danzelphotos-tech/Guardian/figures/bicep_curl_flex_vs_imu.png

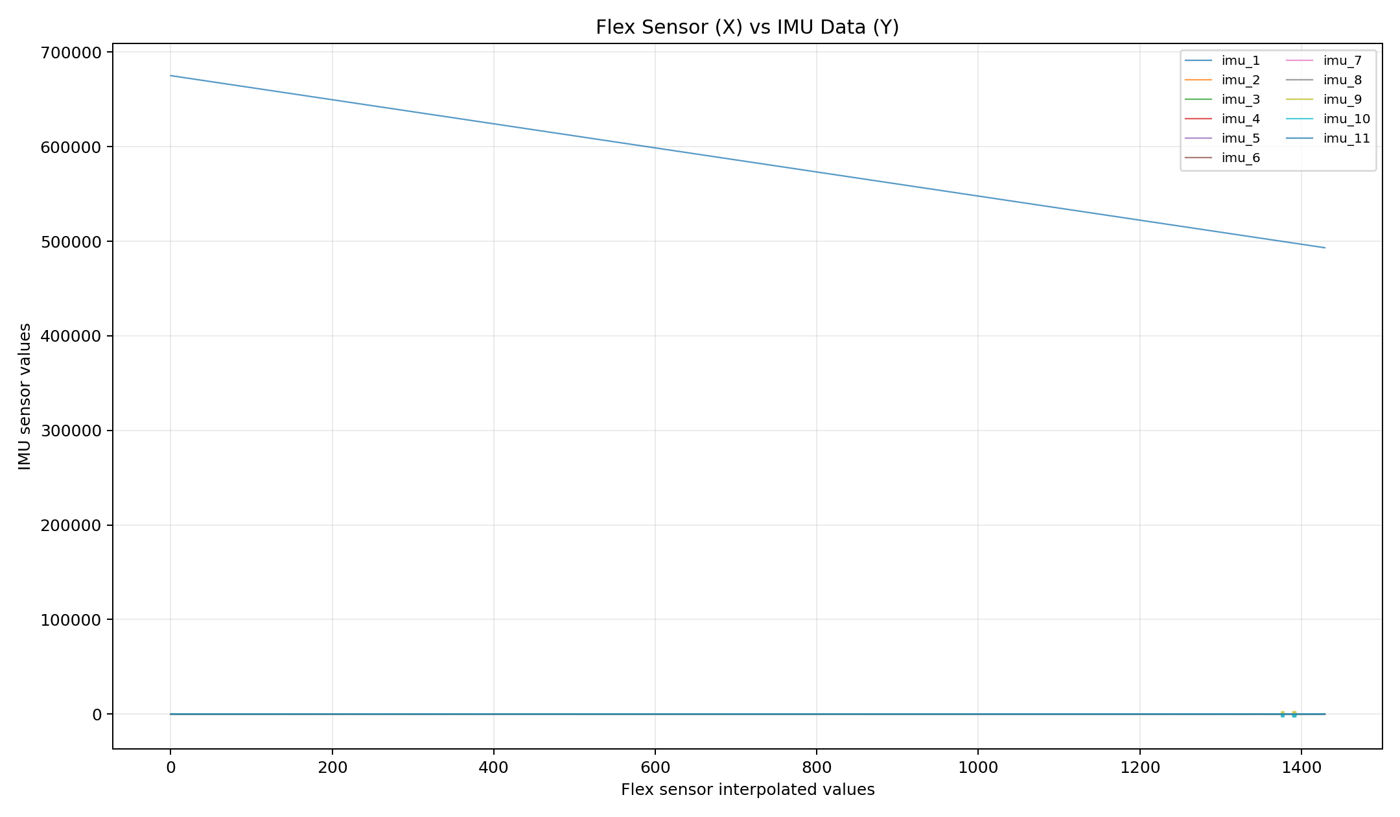
figures/bicep_curl_flex_vs_imu.png
