danzelphotos-tech/Guardian/figures/curl_analysis.png

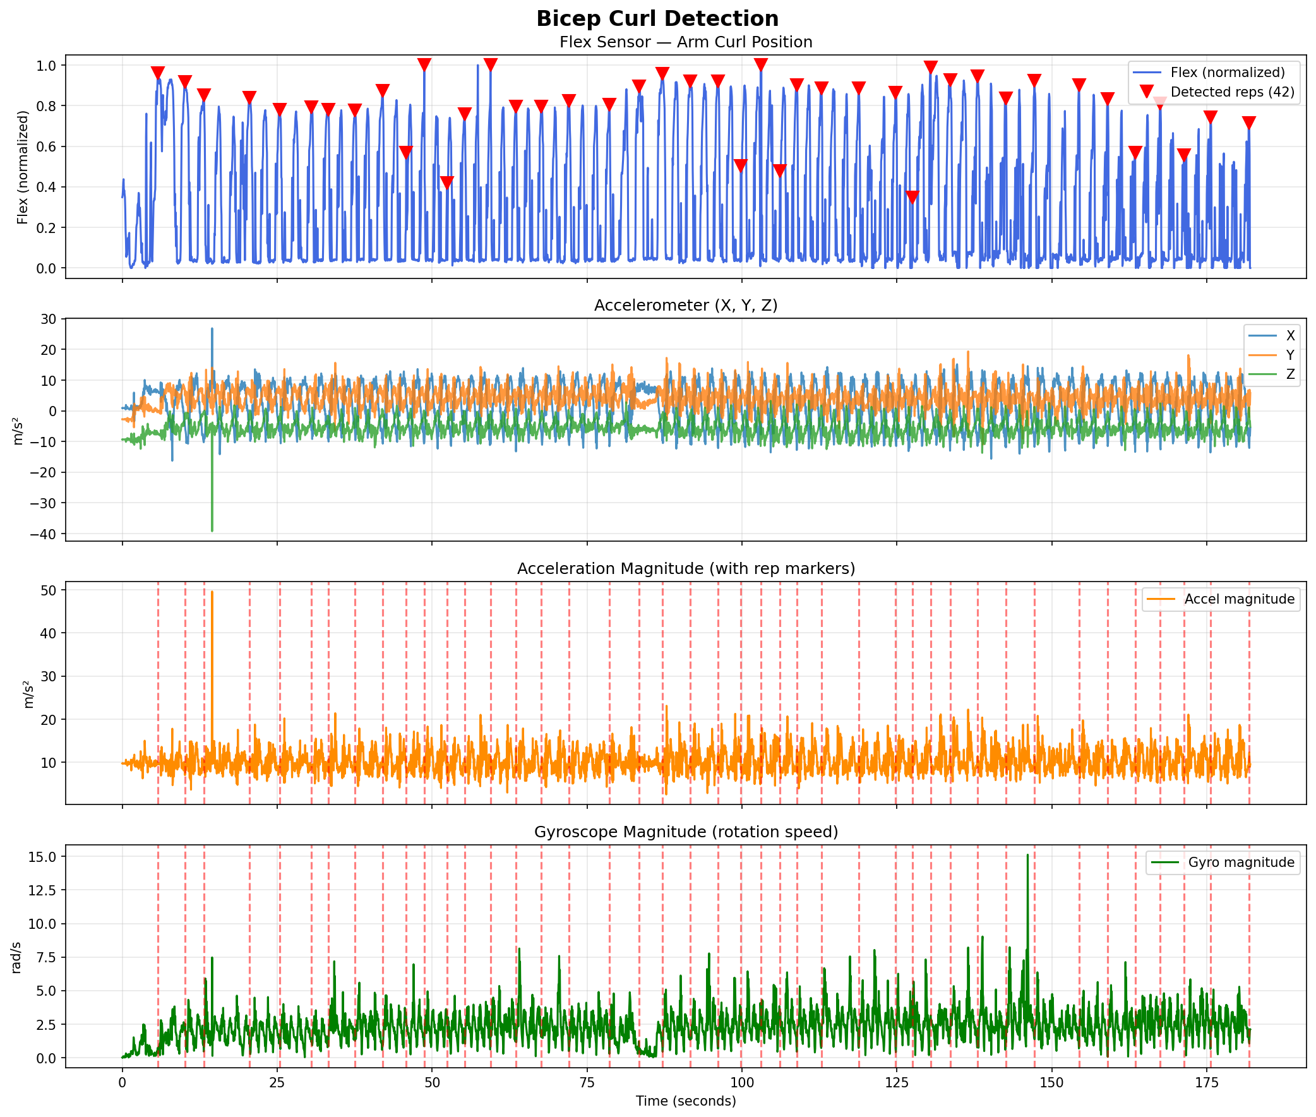
figures/curl_analysis.png
