danzelphotos-tech/Guardian/figures/curl_filtered.png

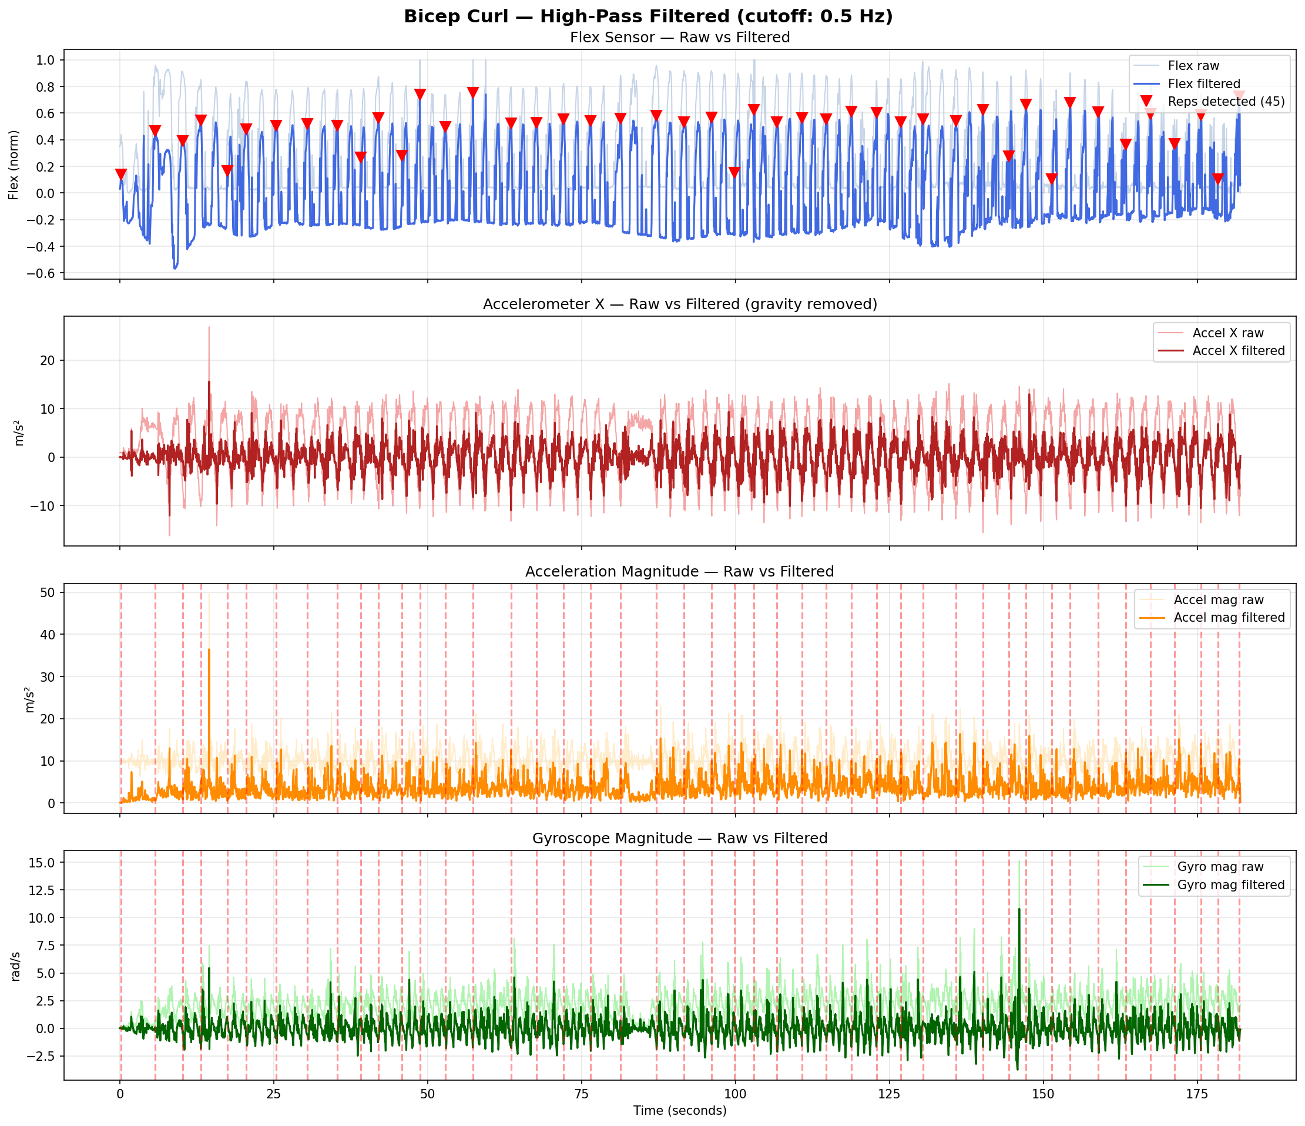
figures/curl_filtered.png
