danzelphotos-tech/Guardian/figures/fig1_flex.png

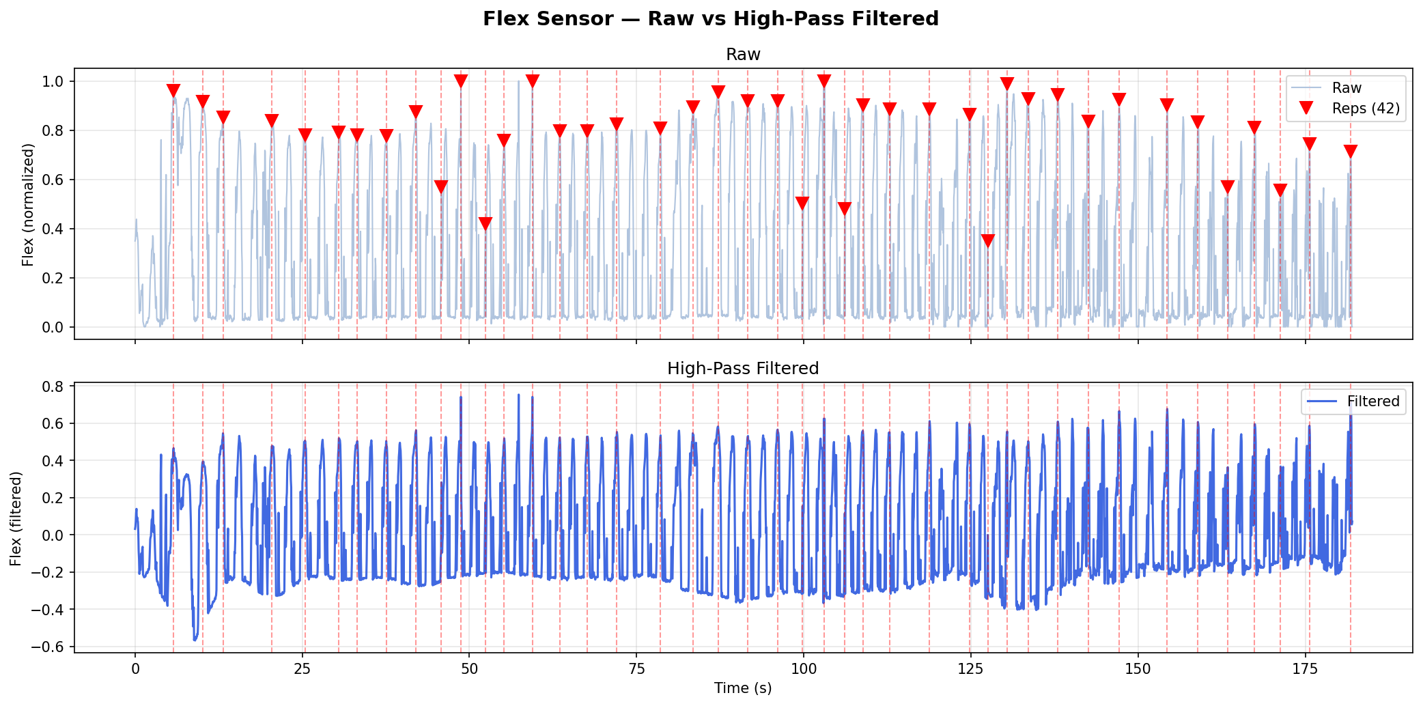
figures/fig1_flex.png
