danzelphotos-tech/Guardian/figures/fig2_accel_x.png

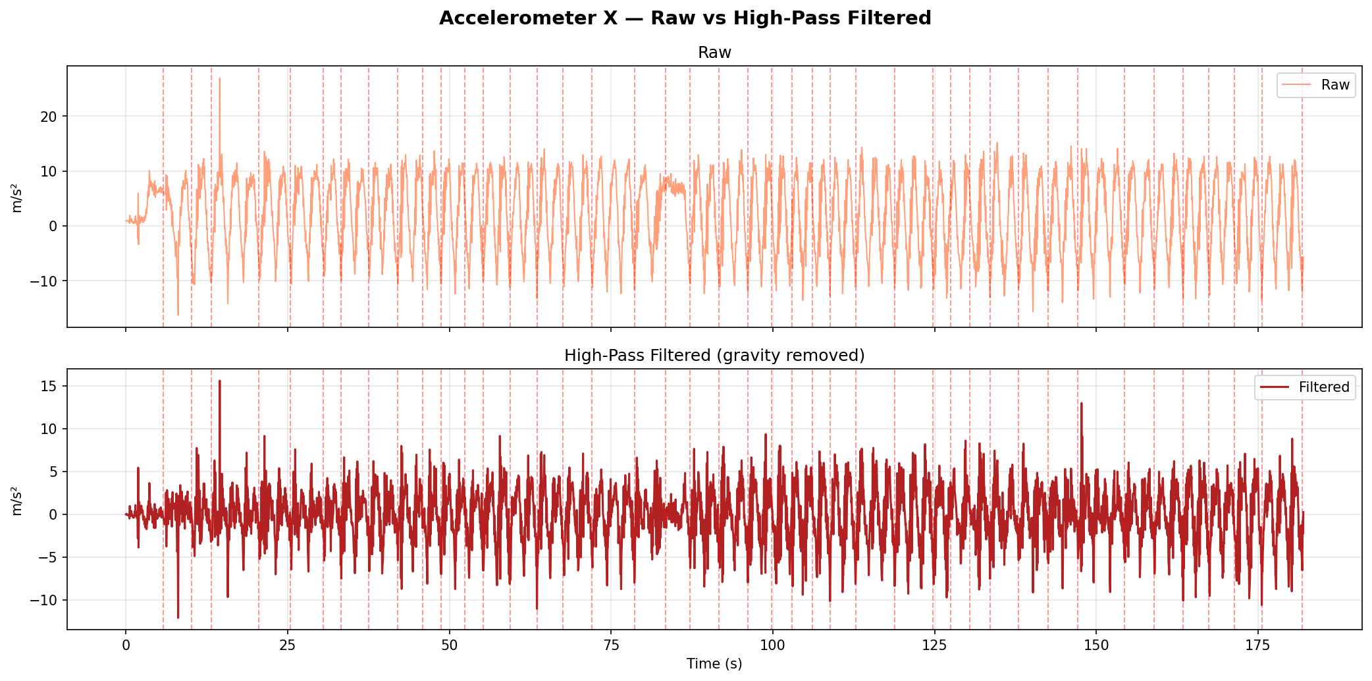
figures/fig2_accel_x.png
