danzelphotos-tech/Guardian/figures/fig3_accel_y.png

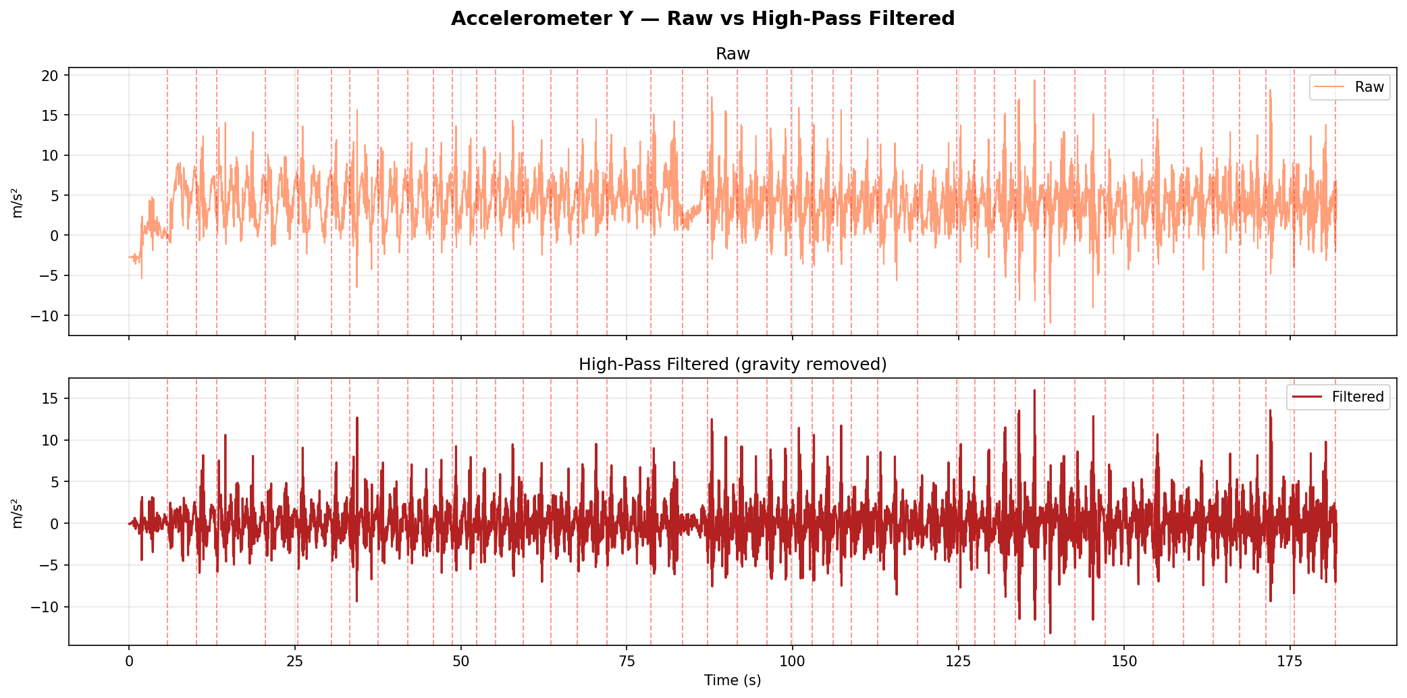
figures/fig3_accel_y.png
