danzelphotos-tech/Guardian/figures/fig4_accel_z.png

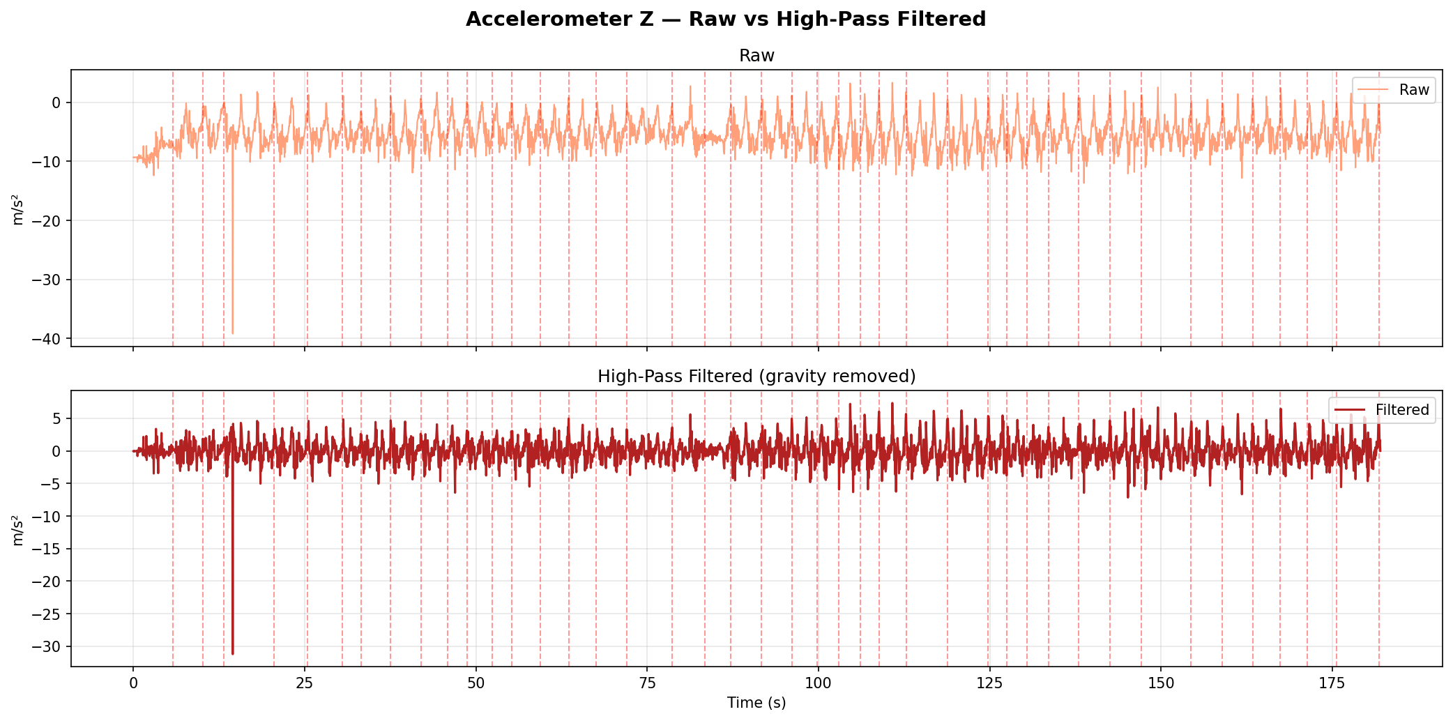
figures/fig4_accel_z.png
