danzelphotos-tech/Guardian/figures/fig5_accel_mag.png

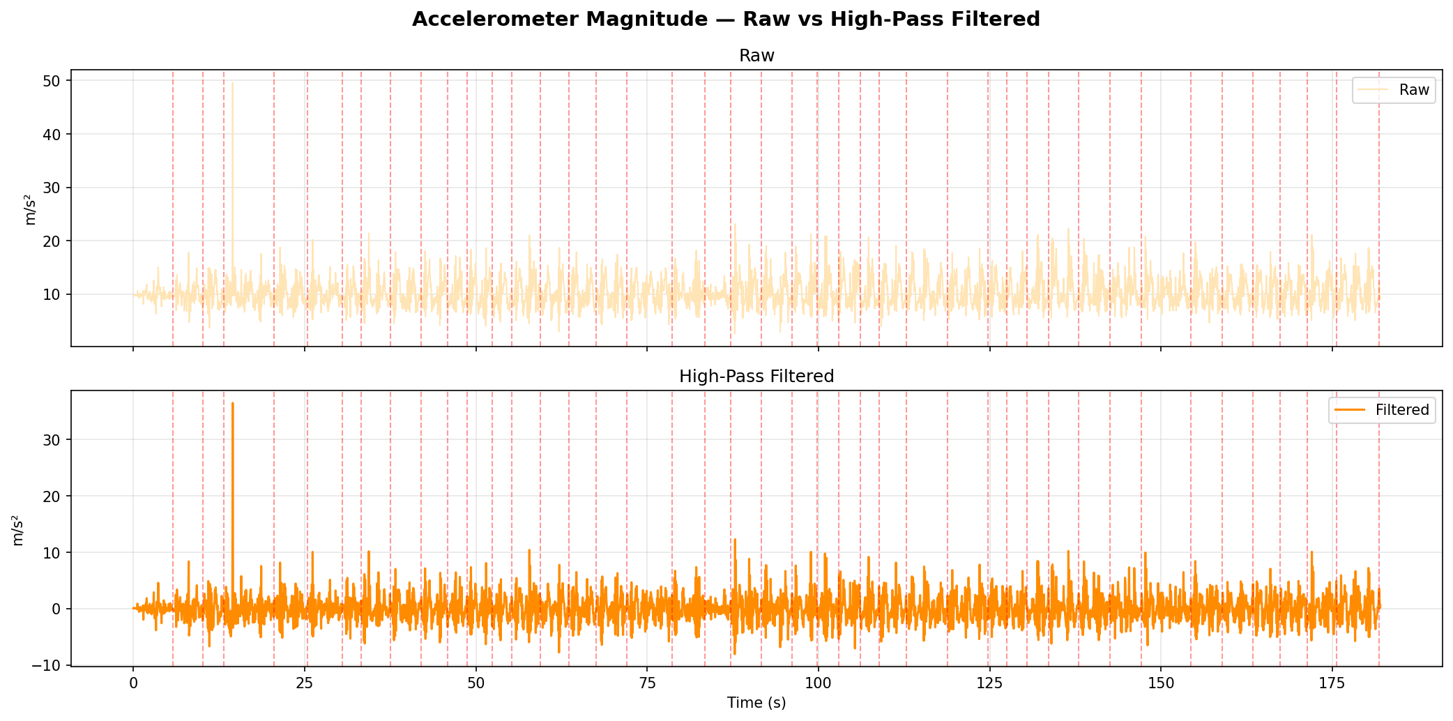
figures/fig5_accel_mag.png
