danzelphotos-tech/Guardian/figures/fig6_gyro_x.png

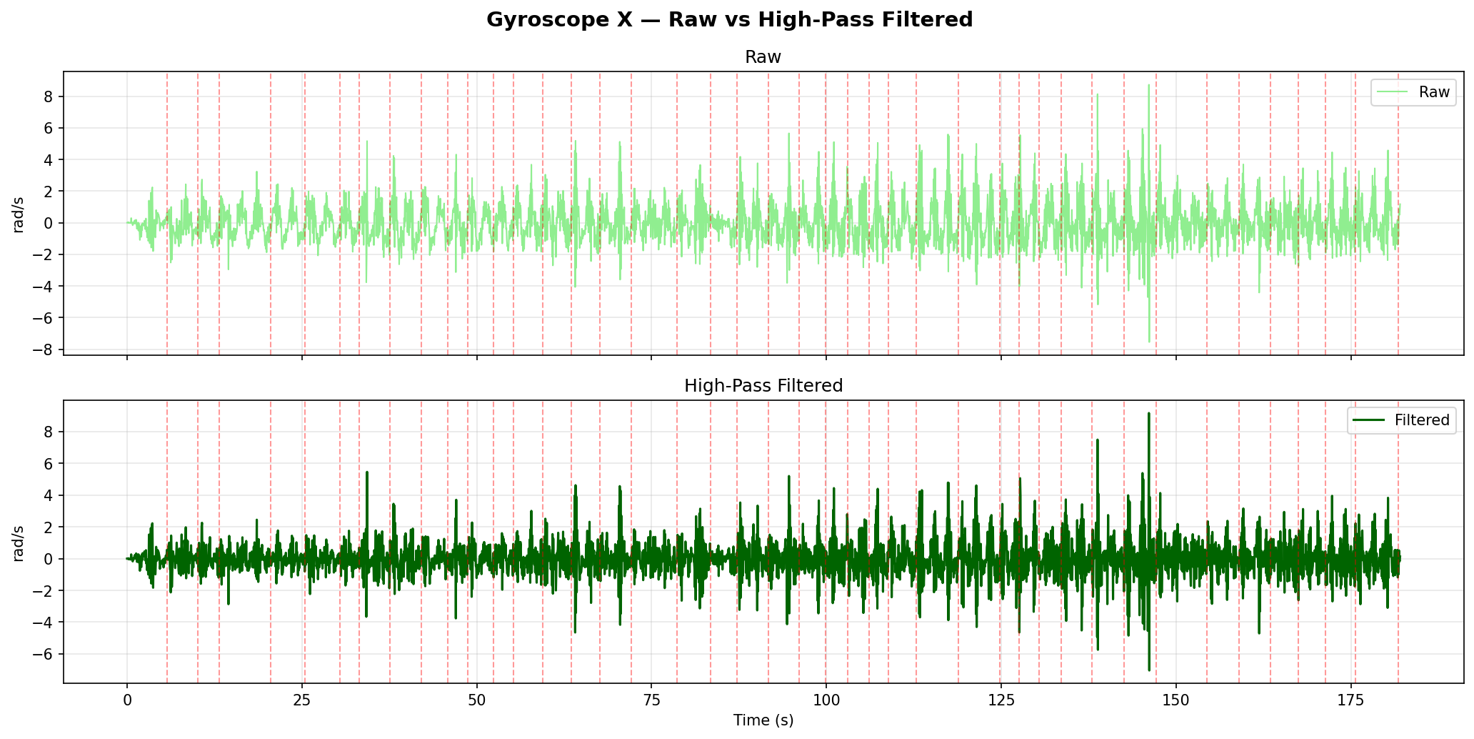
figures/fig6_gyro_x.png
