danzelphotos-tech/Guardian/figures/fig7_gyro_y.png

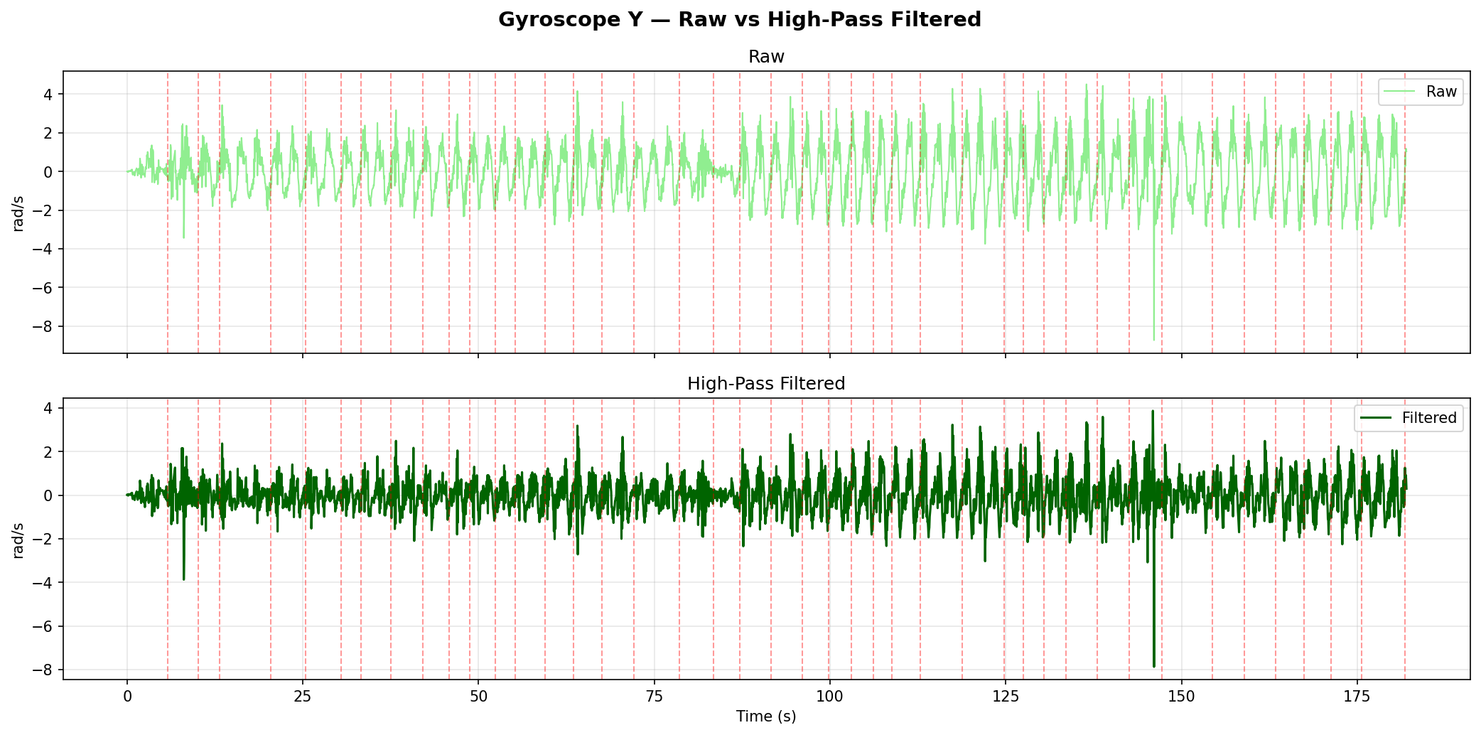
figures/fig7_gyro_y.png
