danzelphotos-tech/Guardian/figures/fig8_gyro_z.png

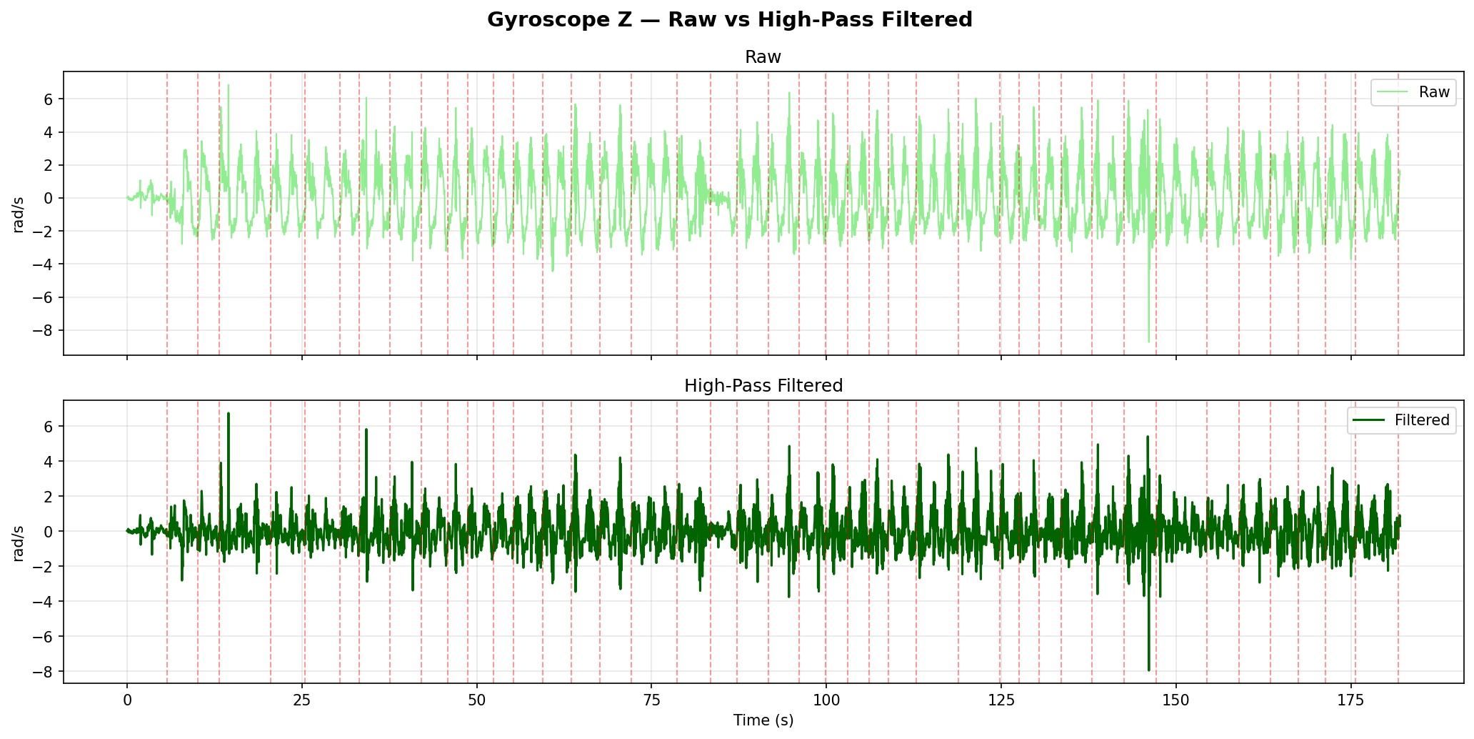
figures/fig8_gyro_z.png
