danzelphotos-tech/Guardian/figures/fig9_gyro_mag.png

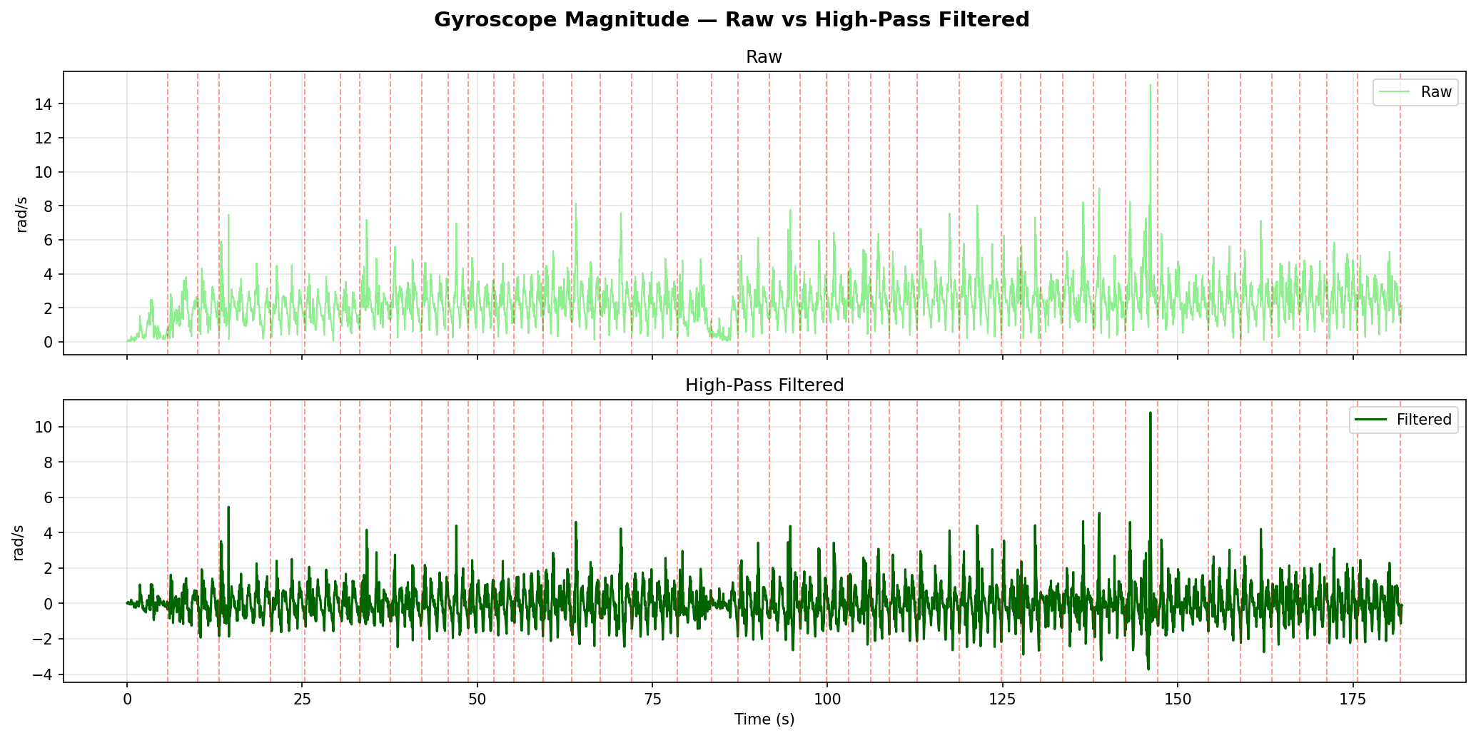
figures/fig9_gyro_mag.png
