danzelphotos-tech/Guardian/capture_veronika/Guardian — Veronika's LED Feedback Sandbox.pdf

Guardian — LED Feedback Sandbox

Load your CSVs, simulate reps from real data, and watch the LED respond to good vs bad form.

capture_veronika / simulation-dashboard-veronika.html

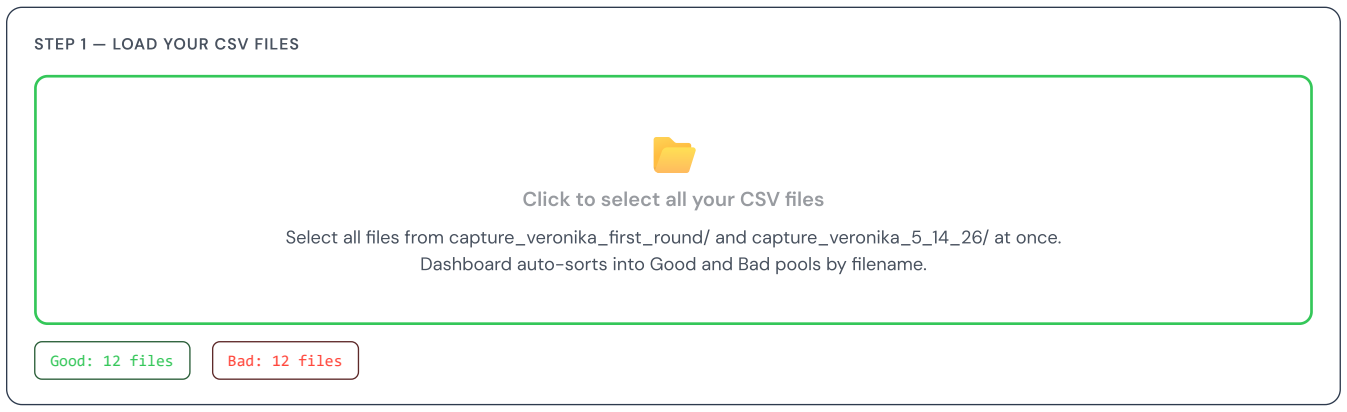
[picture p13: figure]
STEP 1 — LOAD YOUR CSV FILES; Click to select all your CSV files; Good: 12 files; Bad: 12 files

Select all files from capture_veronika_first_round/ and capture_veronika_5_14_26/ at once.

Dashboard auto-sorts into Good and Bad pools by filename.

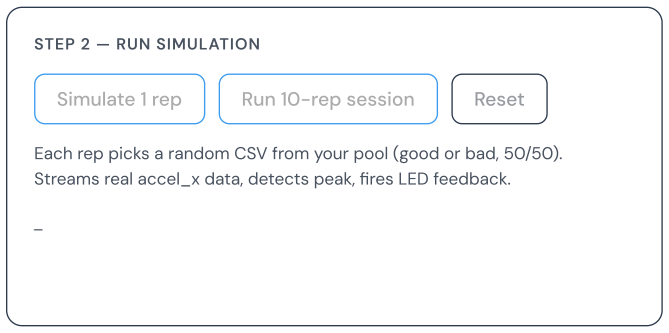
[picture p14: figure]
STEP 2 — RUN SIMULATION; Simulate 1 rep; Run 10-rep session; Reset
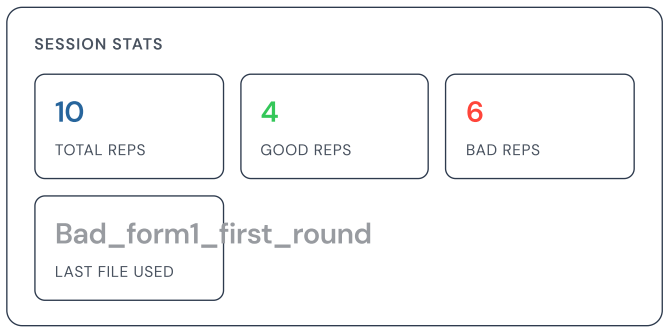
[picture p15: figure]
SESSION STATS; TOTAL REPS; GOOD REPS; BAD REPS; Bad_form1_first_round; LAST FILE USED

Each rep picks a random CSV from your pool (good or bad, 50/50).

Streams real accel_x data, detects peak, fires LED feedback.

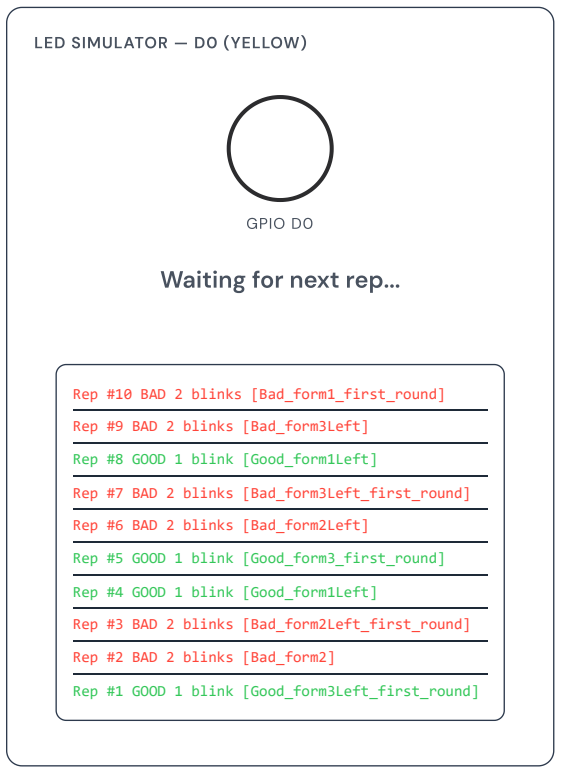
[picture p16: figure]
LED SIMULATOR — D0 (YELLOW); GPIO D0; Waiting for next rep...; Rep #9 BAD 2 blinks [Bad_form3Left]; Rep #8 GOOD 1 blink [Good_form1Left]; Rep #6 BAD 2 blinks [Bad_form2Left]; Rep #4 GOOD 1 blink [Good_form1Left]; Rep #2 BAD 2 blinks [Bad_form2]

Rep #10 BAD 2 blinks [Bad_form1_first_round]

Rep #7 BAD 2 blinks [Bad_form3Left_first_round]

Rep #5 GOOD 1 blink [Good_form3_first_round]

Rep #3 BAD 2 blinks [Bad_form2Left_first_round]

Rep #1 GOOD 1 blink [Good_form3Left_first_round]

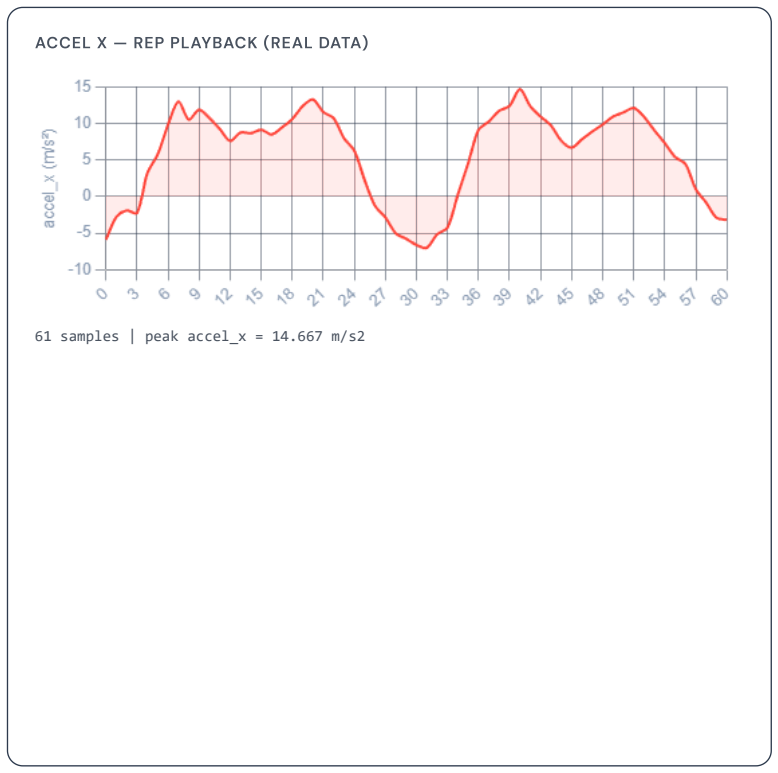
[picture p17: figure]
ACCEL X — REP PLAYBACK (REAL DATA); 61 samples | peak accel_x = 14.667 m/s2

FORM RESULT — ALL REPS | BLINK TIMING — TUNE HERE, COPY TO ARDUINO
5/25/26, 9:41 PM | Guardian — Veronika's LED Feedback Sandbox
file:///C:/Users/pon45/Documents/515/Group Project/Guardian/capture_veronika/simulation-dashboard-veronika.html | 1/2

5/25/26, 9:41 PM | Guardian — Veronika's LED Feedback Sandbox

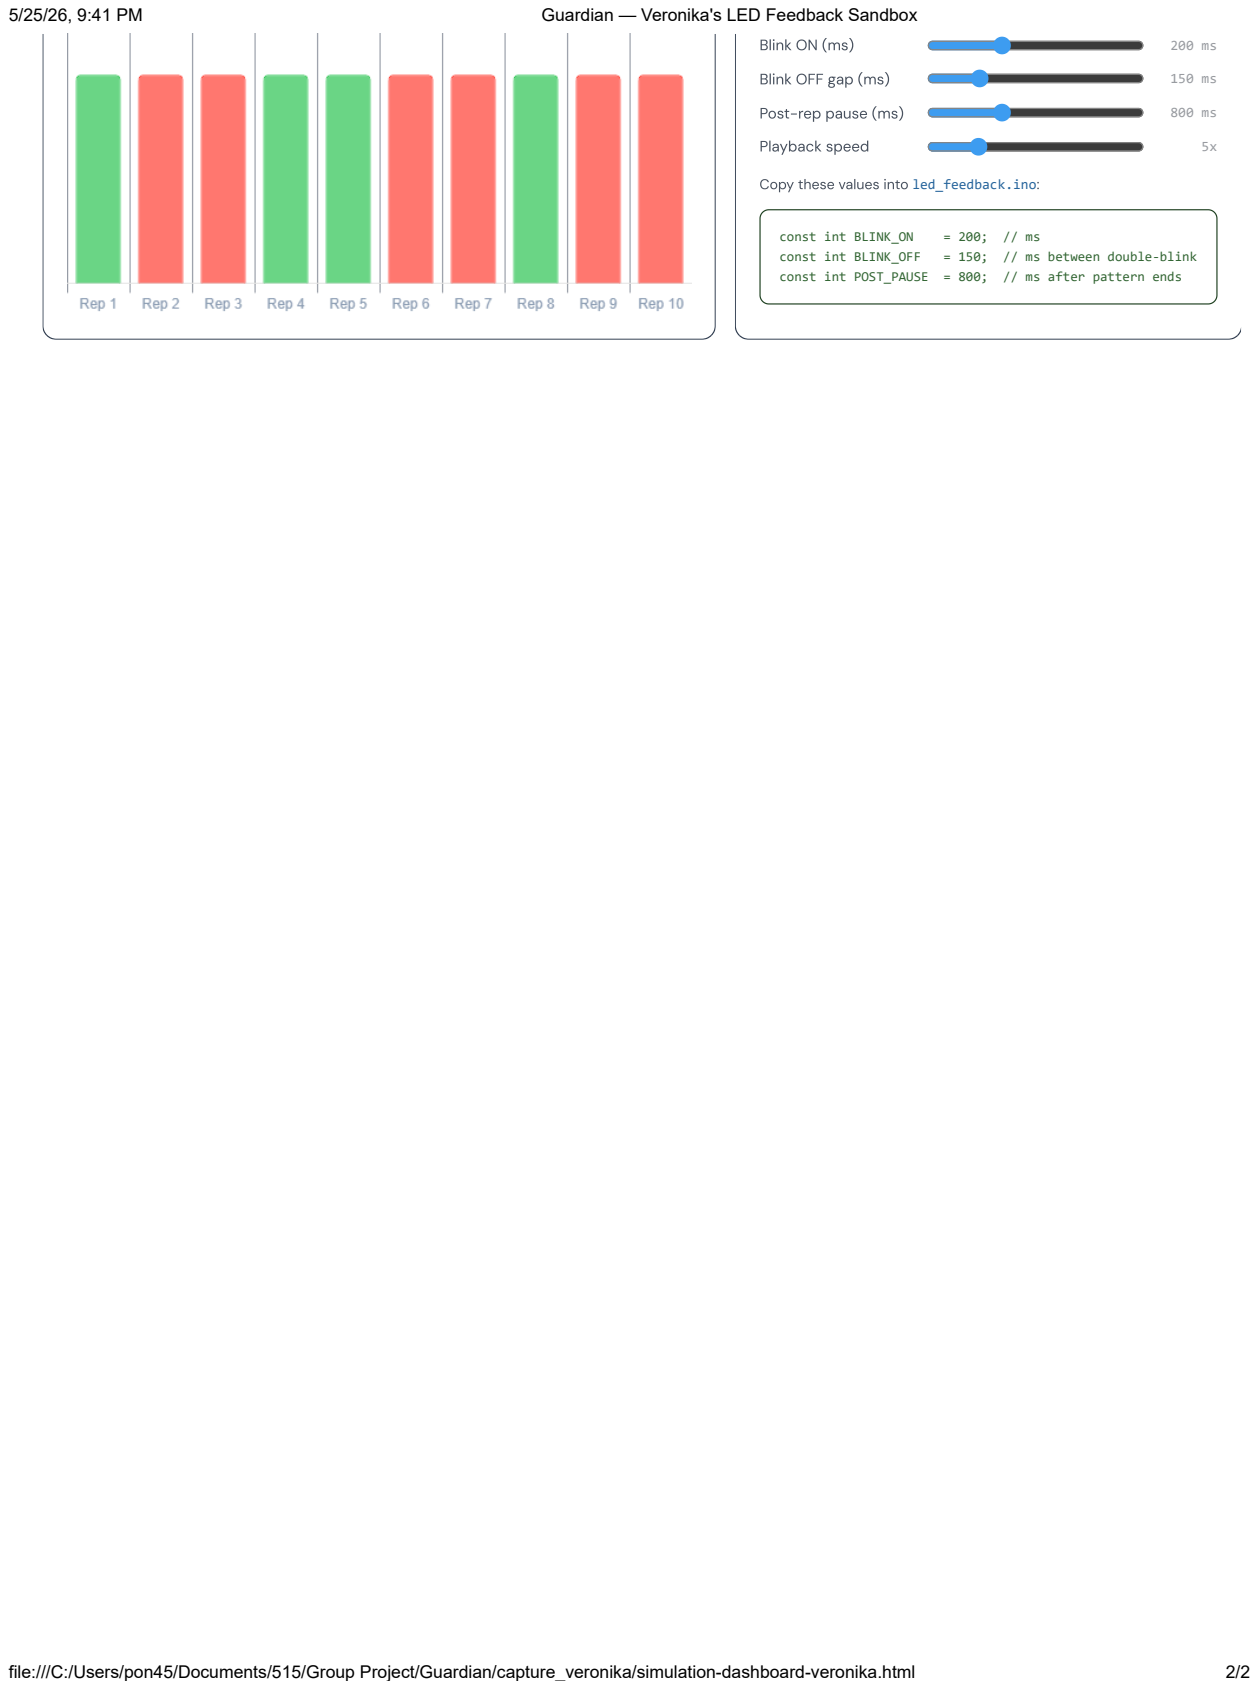
[picture p18: page 2]
Blink ON (ms); Blink OFF gap (ms); Post-rep pause (ms); Playback speed; const int BLINK_ON; const int BLINK_OFF; = 150; // ms between double-blink; file:///C:/Users/pon45/Documents/515/Group Project/Guardian/capture_veronika/simulation-dashboard-veronika.html

Copy these values into led_feedback.ino:

const int POST_PAUSE = 800; // ms after pattern ends
