danzelphotos-tech/Guardian/(commit log)

2026-04-20 Add Firebase Firestore integration and expanded sensor dashboard
    - Renamed to Guardian Data Dashboard
    - Added Firebase Firestore real-time data pipeline (write + onSnapshot)
    - Added flex sensor chart, IMU raw data panel, form score trend, rep comparison
    - Payload schema v2: angle_series, flex_series, imu_accel, imu_gyro, flex_raw
    - Firebase/Local mode toggle for testing without cloud
    - Added firebase.json, firestore.rules, firestore.indexes.json config
    Made-with: Cursor
2026-04-20 Add ICM20948 IMU and flex sensor reading code
    This code initializes an ICM20948 IMU and reads data from it along with a flex sensor. It prints the accelerometer, gyroscope, magnetometer, temperature, and flex sensor readings to the Serial Monitor.
2026-04-28 Add files via upload
    Bicep Curls Data
    [bicep_curl_good_form.csv]
2026-04-28 rough plotting, with images, parsing and filtering comparison with the raw data
    [bicep_curl_good_form_parsed.csv, sensor_data_labeled.csv]
2026-05-08 Refactor sensor code and improve comments
    Refactor sensor code for clarity and efficiency, including improved comments and streamlined data output.
2026-05-08 Add bicep curl form classifier using Random Forest
    Implement a Random Forest classifier to evaluate bicep curl form using IMU data.
2026-05-11 Update sensor placement instructions in README
2026-05-12 Veronika's data collection is in capture_veronika 3 good 3 bad for each head
    [v2_bicep_curl_VeronikaBad_form1.csv, v2_bicep_curl_VeronikaBad_form1Left.csv, v2_bicep_curl_VeronikaBad_form2.csv, v2_bicep_curl_VeronikaBad_form2Left.csv, v2_bicep_curl_VeronikaBad_form3.csv, v2_bicep_curl_VeronikaBad_form3Left.csv, v2_bicep_curl_VeronikaGood_form1.csv, v2_bicep_curl_VeronikaGood_form1Left.csv]
2026-05-15 captured more data for bicep curls
    [v2_bicep_curl_VeronikaBad_form1.csv, v2_bicep_curl_VeronikaBad_form1Left.csv, v2_bicep_curl_VeronikaBad_form2.csv, v2_bicep_curl_VeronikaBad_form2Left.csv, v2_bicep_curl_VeronikaBad_form3.csv, v2_bicep_curl_VeronikaBad_form3Left.csv, v2_bicep_curl_VeronikaGood_form1.csv, v2_bicep_curl_VeronikaGood_form1Left.csv]
2026-05-26 feat: LED feedback prototype, simulation dashboard, CSV pooling, figures folder
    [v2_bicep_curl_VeronikaBad_form1.csv, v2_bicep_curl_VeronikaBad_form1Left.csv, v2_bicep_curl_VeronikaBad_form1Left_first_round.csv, v2_bicep_curl_VeronikaBad_form1_first_round.csv, v2_bicep_curl_VeronikaBad_form2.csv, v2_bicep_curl_VeronikaBad_form2Left.csv, v2_bicep_curl_VeronikaBad_form2Left_first_round.csv, v2_bicep_curl_VeronikaBad_form2_first_round.csv]
2026-05-29 Veronika's lateral raises data collected
    [v2_lateral_raise_VeronikaBadLeft_form1.csv, v2_lateral_raise_VeronikaBadLeft_form2.csv, v2_lateral_raise_VeronikaBadLeft_form3.csv, v2_lateral_raise_VeronikaBad_form1.csv, v2_lateral_raise_VeronikaBad_form2.csv, v2_lateral_raise_VeronikaBad_form3.csv, v2_lateral_raise_VeronikaGoodLeft_form1.csv, v2_lateral_raise_VeronikaGoodLeft_form2.csv]
2026-06-08 Add workout-armband project files
    [v2_DumbbellRow_DanBad_form01.csv, v2_DumbbellRow_DanBad_form02.csv, v2_DumbbellRow_DanBad_form03.csv, v2_DumbbellRow_DanBad_form04.csv, v2_DumbbellRow_DanBad_form05.csv, v2_DumbbellRow_DanBad_form06.csv, v2_DumbbellRow_DanBad_form07.csv, v2_DumbbellRow_DanBad_form08.csv]
2026-06-09 Move 210 files older than 48h to OLD DATA FILES
    Files not uploaded/modified since June 7 2026 have been moved to
    the OLD DATA FILES folder, preserving their original directory structure.
    [bicep_curl_good_form.csv, bicep_curl_good_form_parsed.csv, sensor_data_labeled.csv, v2_bicep_curl_ColeBad_form.csv, v2_bicep_curl_ColeBad_form1.csv, v2_bicep_curl_ColeBad_form10.csv, v2_bicep_curl_ColeBad_form11.csv, v2_bicep_curl_ColeBad_form12.csv]
2026-06-09 Create README.md for Smart Workout Armband
    Add detailed README for Smart Workout Armband project, including team roles, hardware specifications, software architecture, setup instructions, and current status.
